Floyd-Fish/Lab-Precision-VoltageSource/README.md

# Lab-Precision-VoltageSource
A 18-bit Precision Bipolar DAC Module based on LTC2756&amp;LTC6655-2.5 with PMOD Interface

Article explaining the principle: https://www.emoe.xyz/precision-voltage-source-design/

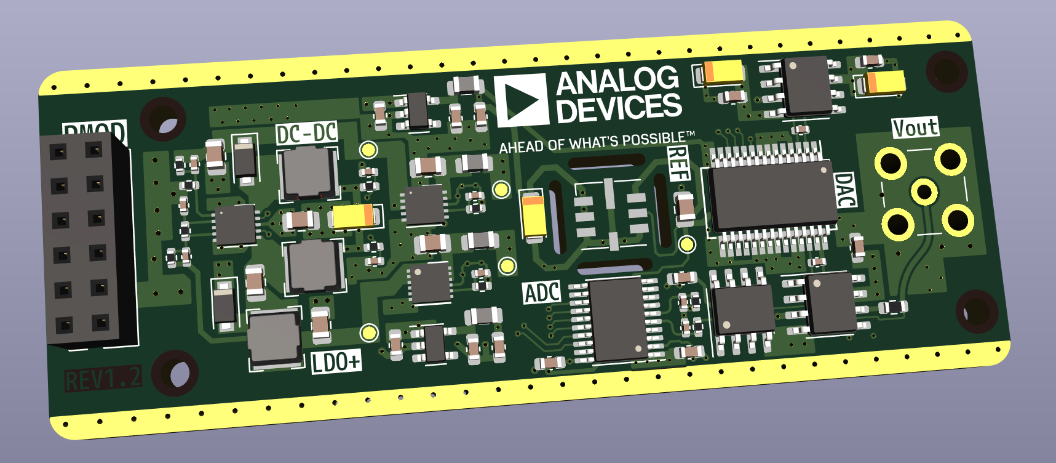
[picture p1: img/1.png]


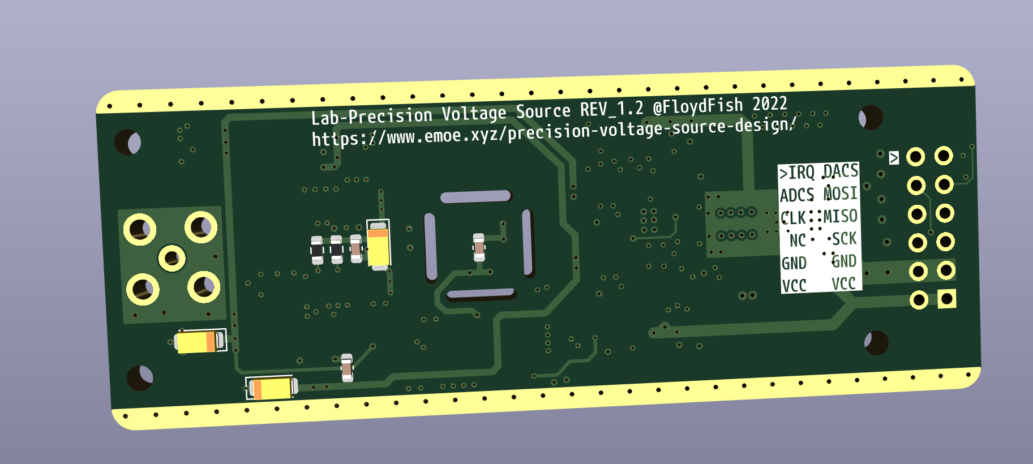
[picture p2: img/2.png]
