Floyd-Fish/Lab-Precision-VoltageSource/LabPrecisionVoltageSource_V1.2/LabPrecisionVoltageSource_V1.2.kicad_pcb

## KiCad design LabPrecisionVoltageSource_V1.2/LabPrecisionVoltageSource_V1.2.kicad_pcb (2023-03-18)

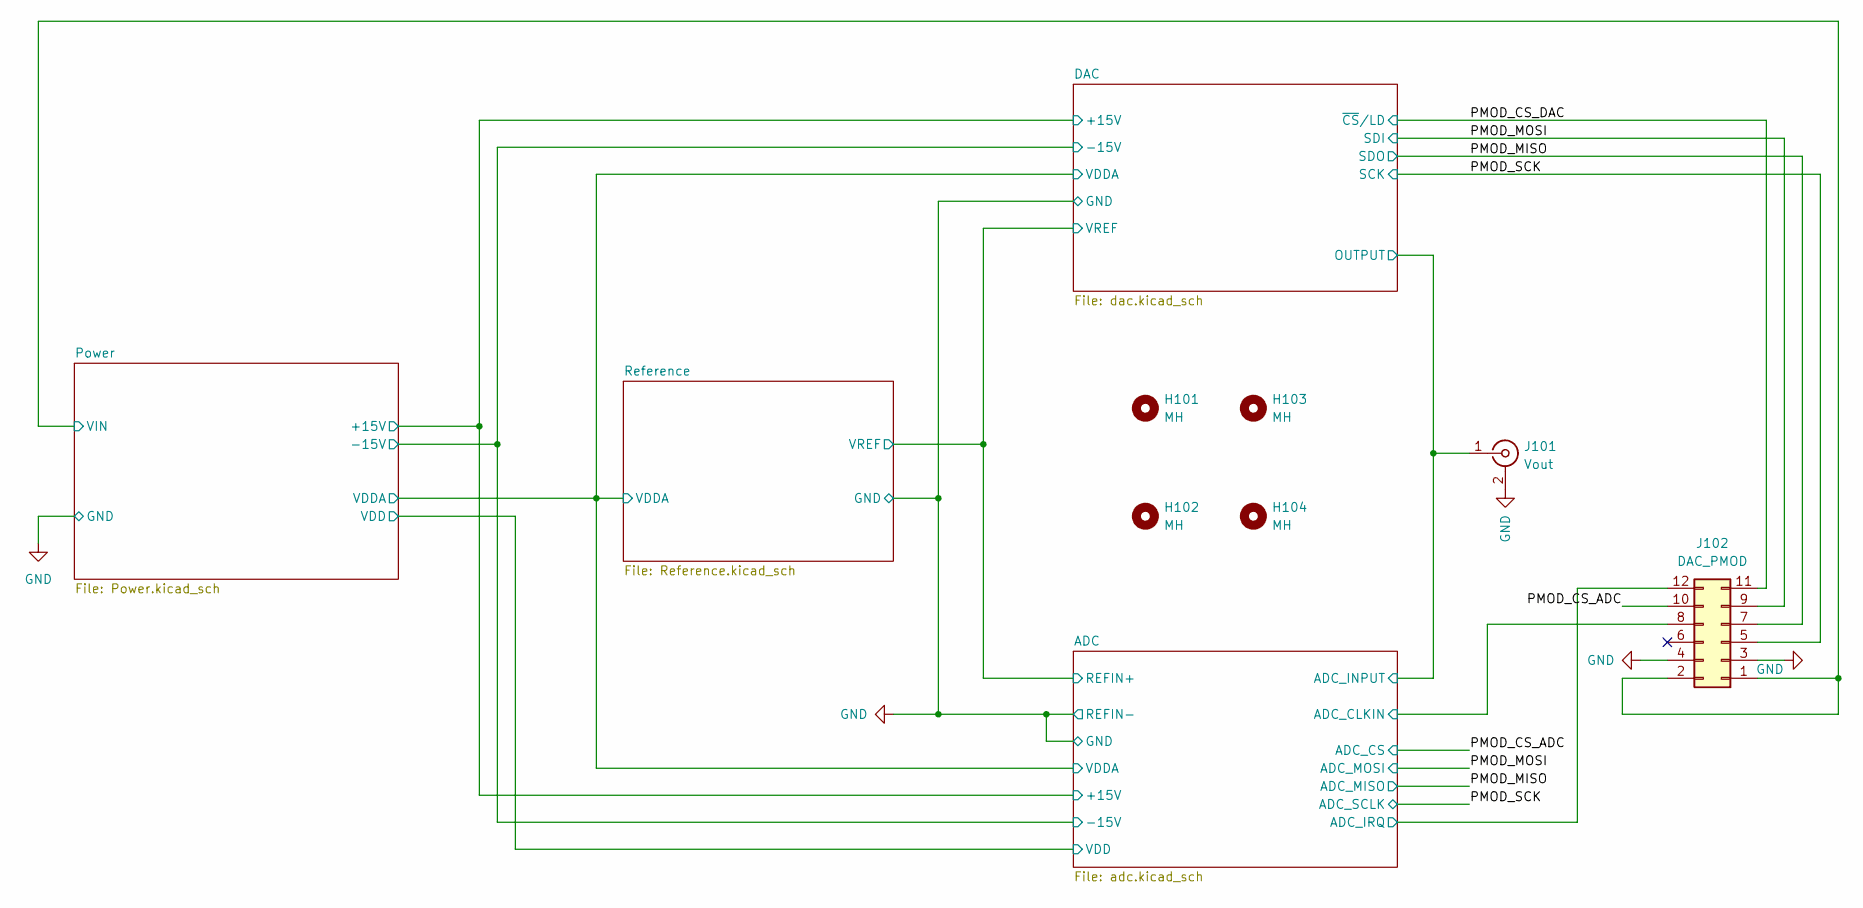
[picture p3: schematic LabPrecisionVoltageSource_V1.2.kicad_sch]

Parts:
H101, H102, H103, H104: MH; MountingHole_2.2mm_M2_ISO7380
J101: Vout; SMB_Jack_Vertical
J102: DAC_PMOD; PinSocket_2x06_P2.54mm_Vertical

Connections:
/ADC/ADC_CLKIN: J102.8; also elsewhere on the board
/ADC/ADC_INPUT: J101.1 (In); also elsewhere on the board
/ADC/ADC_IRQ: J102.12; also elsewhere on the board
/PMOD_CS_ADC: J102.10; also elsewhere on the board
/PMOD_CS_DAC: J102.11; also elsewhere on the board
/PMOD_MISO: J102.7; also elsewhere on the board
/PMOD_MOSI: J102.9; also elsewhere on the board
/PMOD_SCK: J102.5; also elsewhere on the board
GND: J101.2 (Ext), J102.3, J102.4; also elsewhere on the board
VIN: J102.1, J102.2; also elsewhere on the board

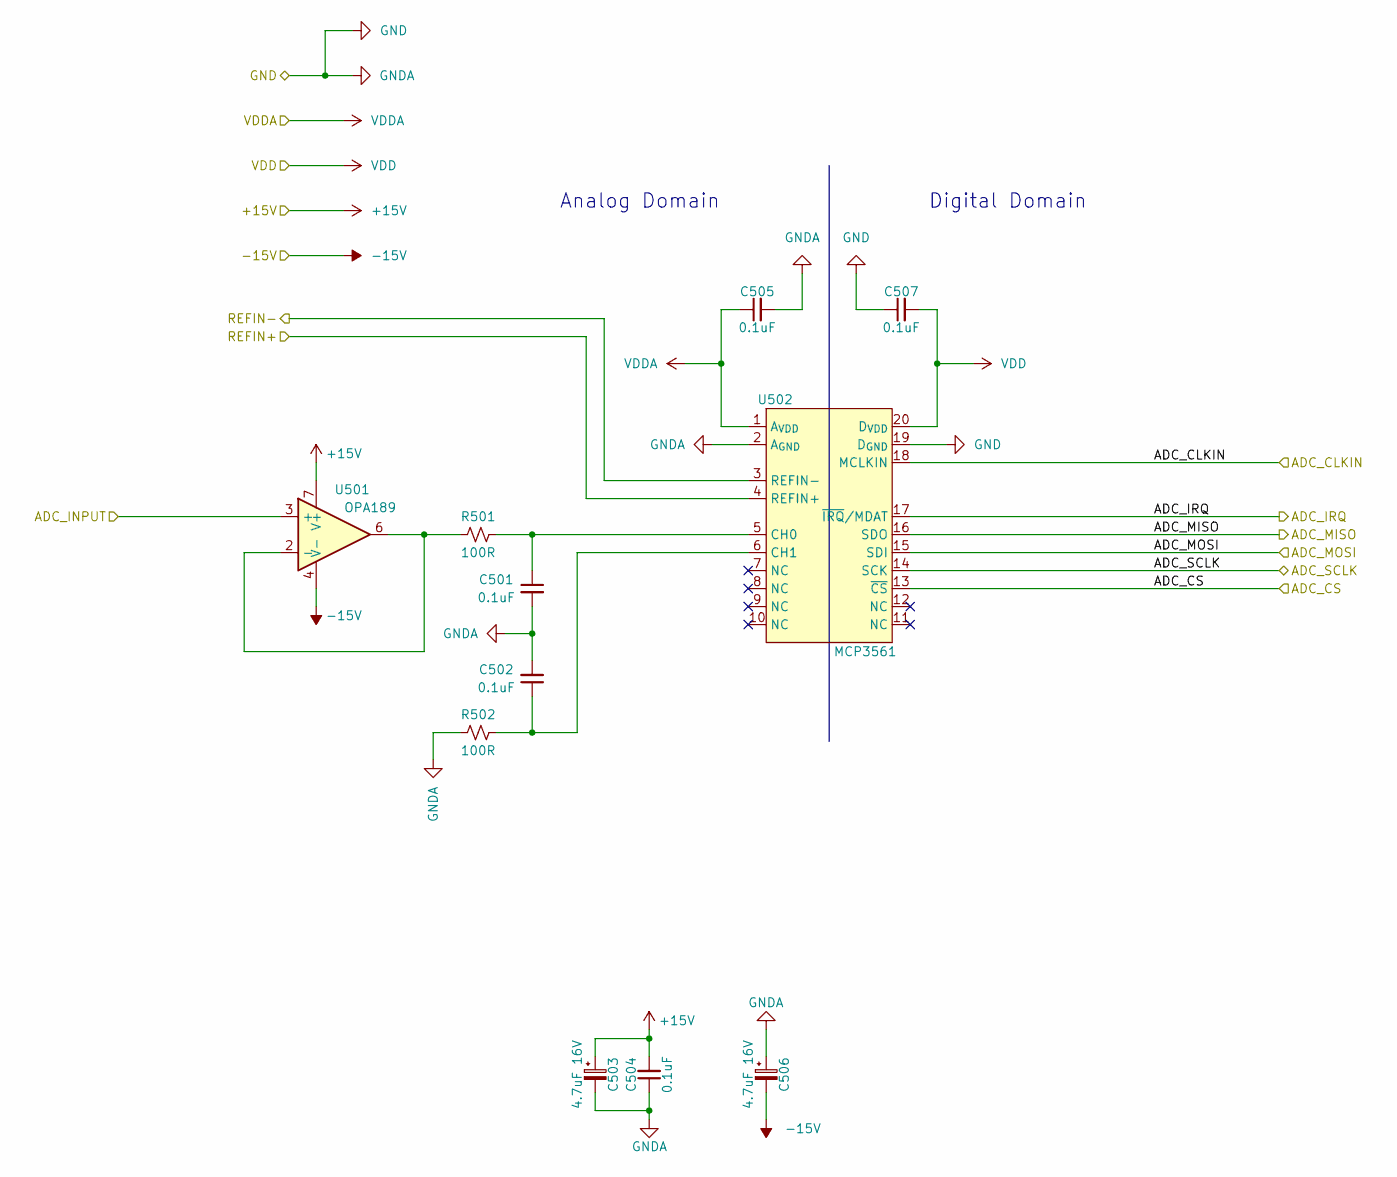
[picture p4: schematic adc.kicad_sch, Lab-Precision Voltage Source]

Parts:
C501, C502: 0.1uF; C_0402_1005Metric
C503, C506: 4.7uF 16V; CP_EIA-3216-10_Kemet-I
C504, C505, C507: 0.1uF; C_0603_1608Metric
R501, R502: 100R; R_0402_1005Metric
U501: OPA189; SOIC-8_3.9x4.9mm_P1.27mm
U502: MCP3561; TSSOP-20_4.4x6.5mm_P0.65mm

Connections:
+15V: C503.1, C504.2, U501.7 (V+); also elsewhere on the board
-15V: C506.2, U501.4 (V-); also elsewhere on the board
/ADC/ADC_CLKIN: U502.18 (MCLKIN); also elsewhere on the board
/ADC/ADC_INPUT: U501.3 (+); also elsewhere on the board
/ADC/ADC_IRQ: U502.17 (~IRQ/MDAT); also elsewhere on the board
/PMOD_CS_ADC: U502.13 (~CS); also elsewhere on the board
/PMOD_MISO: U502.16 (SDO); also elsewhere on the board
/PMOD_MOSI: U502.15 (SDI); also elsewhere on the board
/PMOD_SCK: U502.14 (SCK); also elsewhere on the board
/Reference/VREF: U502.4 (REFIN+); also elsewhere on the board
GND: C501.2, C502.2, C503.2, C504.1, C505.2, C506.1, C507.1, R502.2, U502.2 (A_{GND}), U502.3 (REFIN-), U502.19 (D_{GND}); also elsewhere on the board
unnamed: C501.1, R501.1, U502.5 (CH0)
unnamed: C502.1, R502.1, U502.6 (CH1)
unnamed: R501.2, U501.2 (-), U501.6
VDD: C507.2, U502.20 (D_{VDD}); also elsewhere on the board
VDDA: C505.1, U502.1 (A_{VDD}); also elsewhere on the board

Notes on the sheet:
Analog Domain
Digital Domain

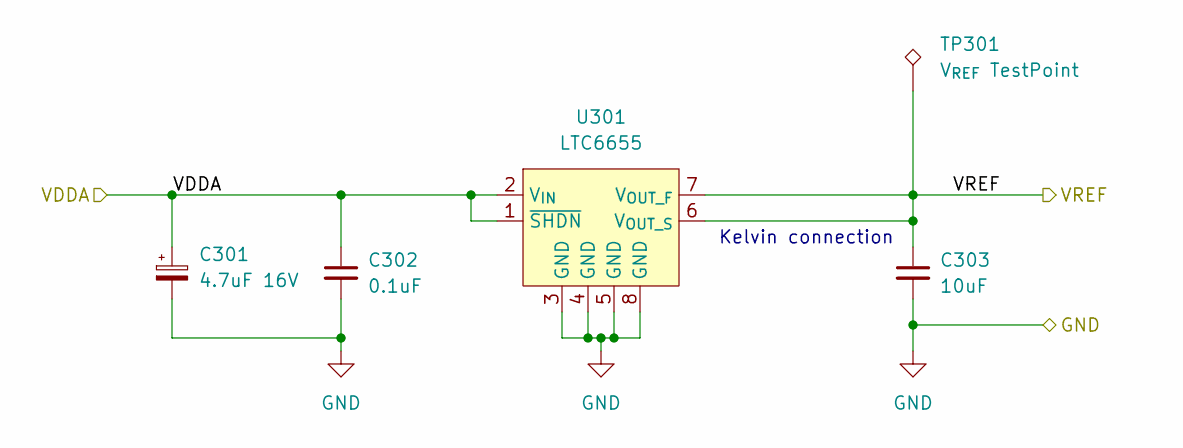
[picture p5: schematic Reference.kicad_sch, Lab-Precision Voltage Source]

Parts:
C301: 4.7uF 16V; CP_EIA-3216-10_Kemet-I
C302: 0.1uF; C_0603_1608Metric
C303: 10uF; C_0805_2012Metric
TP301: V_{REF} TestPoint; TestPoint_Pad_D1.0mm
U301: LTC6655; Linear_LS8

Connections:
/Reference/VREF: C303.1, TP301.1, U301.6 (V_{OUT_S}), U301.7 (V_{OUT_F}); also elsewhere on the board
GND: C301.2, C302.2, C303.2, U301.3 (GND), U301.4 (GND), U301.5 (GND), U301.8 (GND); also elsewhere on the board
VDDA: C301.1, C302.1, U301.1 (~SHDN), U301.2 (V_{IN}); also elsewhere on the board

Notes on the sheet:
Kelvin connection

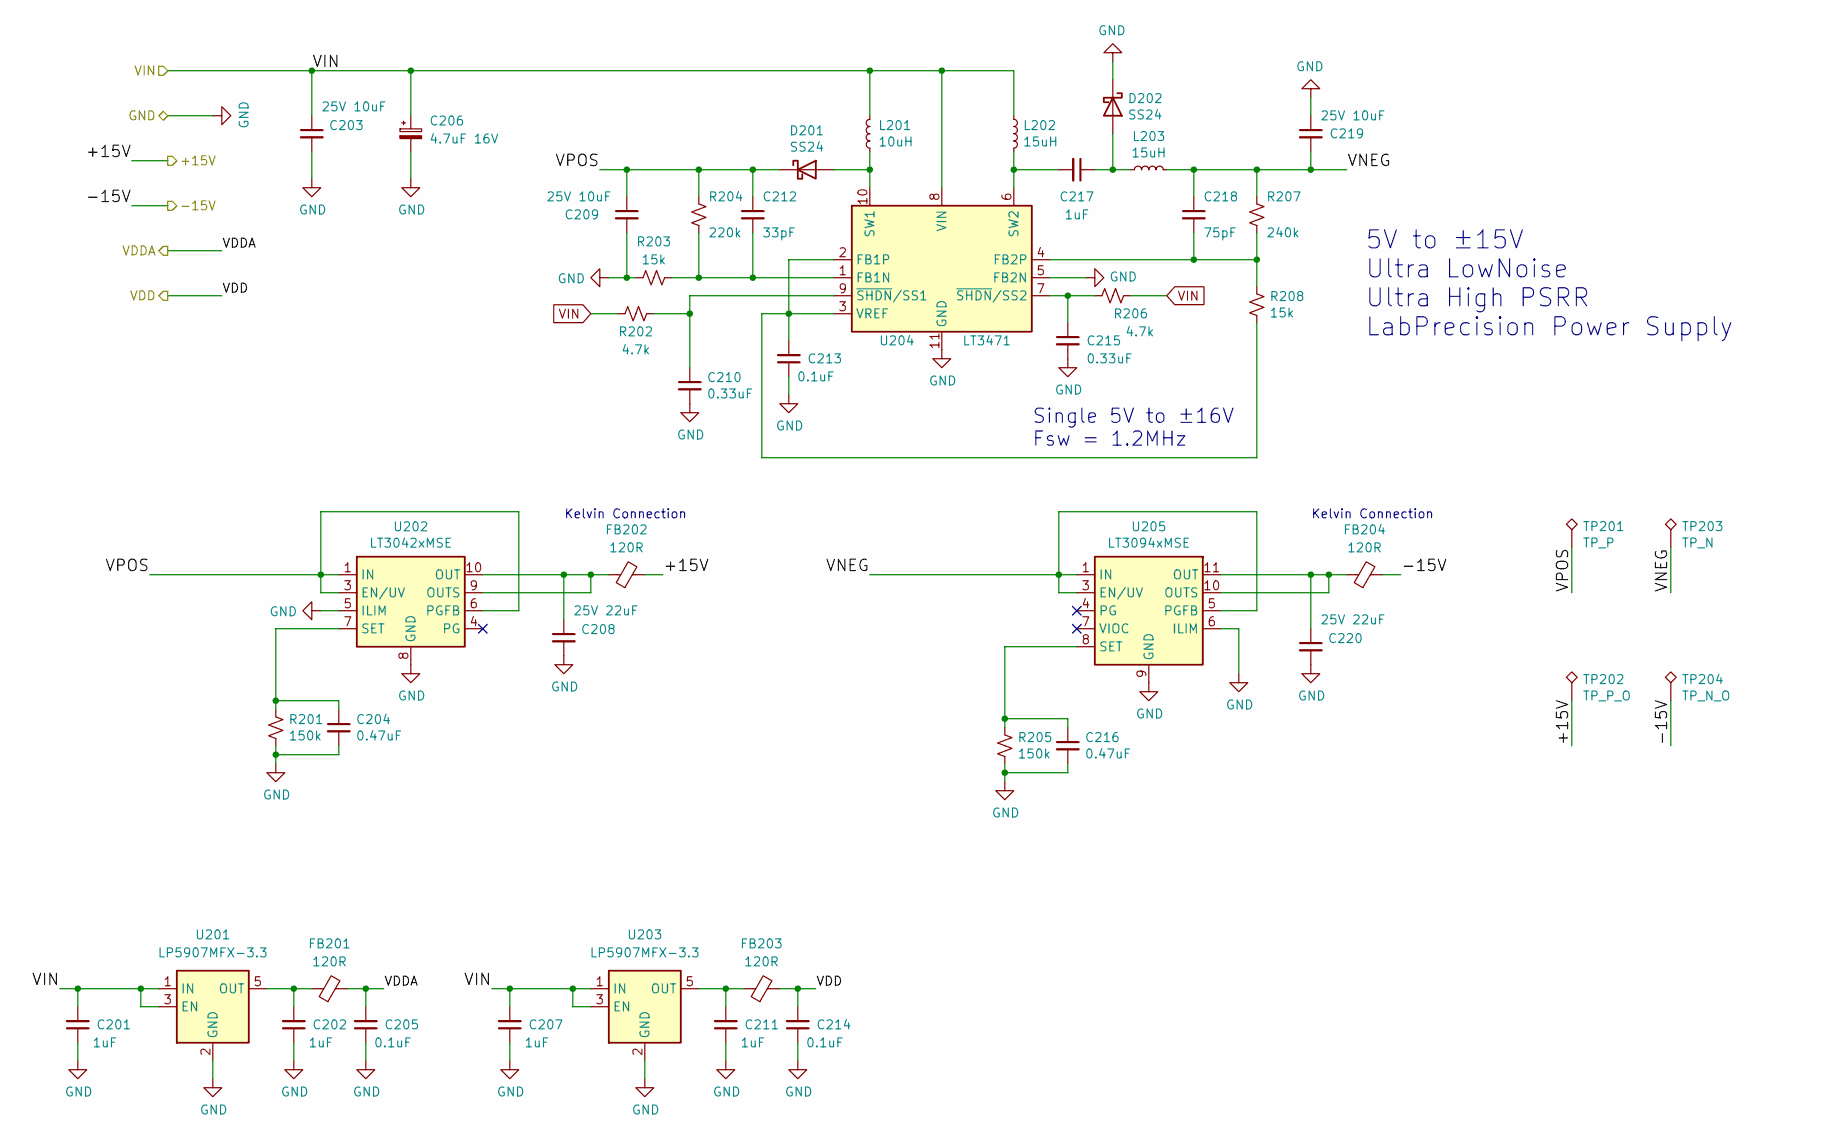
[picture p6: schematic Power.kicad_sch, Lab-Precision Voltage Source]

Parts:
C201, C202, C207, C211: 1uF; C_0603_1608Metric
C203, C209, C219: 25V 10uF; C_0805_2012Metric
C204, C216: 0.47uF; C_0402_1005Metric
C205, C214: 0.1uF; C_0603_1608Metric
C206: 4.7uF 16V; CP_EIA-3216-10_Kemet-I
C208, C220: 25V 22uF; C_0805_2012Metric
C210, C215: 0.33uF; C_0402_1005Metric
C212: 33pF; C_0402_1005Metric
C213: 0.1uF; C_0402_1005Metric
C217: 1uF; C_0805_2012Metric
C218: 75pF; C_0402_1005Metric
D201, D202: SS24; D_SOD-123F
FB201, FB202, FB203, FB204: 120R; L_0805_2012Metric
L201: 10uH; L_Bourns-SRN4018
L202, L203: 15uH; L_Bourns-SRN4018
R201, R205: 150k; R_0402_1005Metric
R202, R206: 4.7k; R_0402_1005Metric
R203, R208: 15k; R_0402_1005Metric
R204: 220k; R_0402_1005Metric
R207: 240k; R_0402_1005Metric
TP201: TP_P; TestPoint_Pad_D1.0mm
TP202: TP_P_O; TestPoint_Pad_D1.0mm
TP203: TP_N; TestPoint_Pad_D1.0mm
TP204: TP_N_O; TestPoint_Pad_D1.0mm
U201, U203: LP5907MFX-3.3; SOT-23-5
U202: LT3042xMSE; DFN-10-1EP_3x3mm_P0.5mm_EP1.65x2.38mm
U204: LT3471; DFN-10-1EP_3x3mm_P0.5mm_EP1.65x2.38mm
U205: LT3094xMSE; DFN-12-1EP_3x3mm_P0.45mm_EP1.66x2.38mm

Connections:
+15V: FB202.2, TP202.1; also elsewhere on the board
-15V: FB204.2, TP204.1; also elsewhere on the board
/Power/VNEG: C218.1, C219.2, L203.2, R207.2, TP203.1, U205.1 (IN), U205.2 (IN), U205.3 (EN/UV), U205.5 (PGFB), U205.13 (IN)
/Power/VPOS: C209.1, C212.1, D201.1 (K), R204.2, TP201.1, U202.1 (IN), U202.2 (IN), U202.3 (EN/UV), U202.6 (PGFB)
GND: C201.1, C202.1, C203.2, C204.2, C205.1, C206.2, C207.1, C208.2, C209.2, C210.2, C211.1, C213.1, C214.1, C215.2, C216.2, C219.1, C220.2, D202.1 (K), R201.1, R203.1, R205.1, U201.2 (GND), U202.5 (ILIM), U202.8 (GND), U202.11 (GND), U203.2 (GND), U204.5 (FB2N), U204.11 (GND), U205.6 (ILIM), U205.9 (GND); also elsewhere on the board
unnamed: C202.2, FB201.1, U201.5 (OUT)
unnamed: C204.1, R201.2, U202.7 (SET)
unnamed: C208.1, FB202.1, U202.9 (OUTS), U202.10 (OUT)
unnamed: C210.1, R202.2, U204.9 (~SHDN/SS1)
unnamed: C211.2, FB203.1, U203.5 (OUT)
unnamed: C212.2, R203.2, R204.1, U204.1 (FB1N)
unnamed: C213.2, R208.1, U204.2 (FB1P), U204.3 (VREF)
unnamed: C215.1, R206.1, U204.7 (~SHDN/SS2)
unnamed: C216.1, R205.2, U205.8 (SET)
unnamed: C217.1, D202.2 (A), L203.1
unnamed: C217.2, L202.2, U204.6 (SW2)
unnamed: C218.2, R207.1, R208.2, U204.4 (FB2P)
unnamed: C220.1, FB204.1, U205.10 (OUTS), U205.11 (OUT), U205.12 (OUT)
unnamed: D201.2 (A), L201.1, U204.10 (SW1)
VDD: C214.2, FB203.2; also elsewhere on the board
VDDA: C205.2, FB201.2; also elsewhere on the board
VIN: C201.2, C203.1, C206.1, C207.2, L201.2, L202.1, R202.1, R206.2, U201.1 (IN), U201.3 (EN), U203.1 (IN), U203.3 (EN), U204.8 (VIN); also elsewhere on the board

Notes on the sheet:
Kelvin Connection
Single 5V to ±16V Fsw = 1.2MHz
5V to ±15V Ultra LowNoise Ultra High PSRR LabPrecision Power Supply

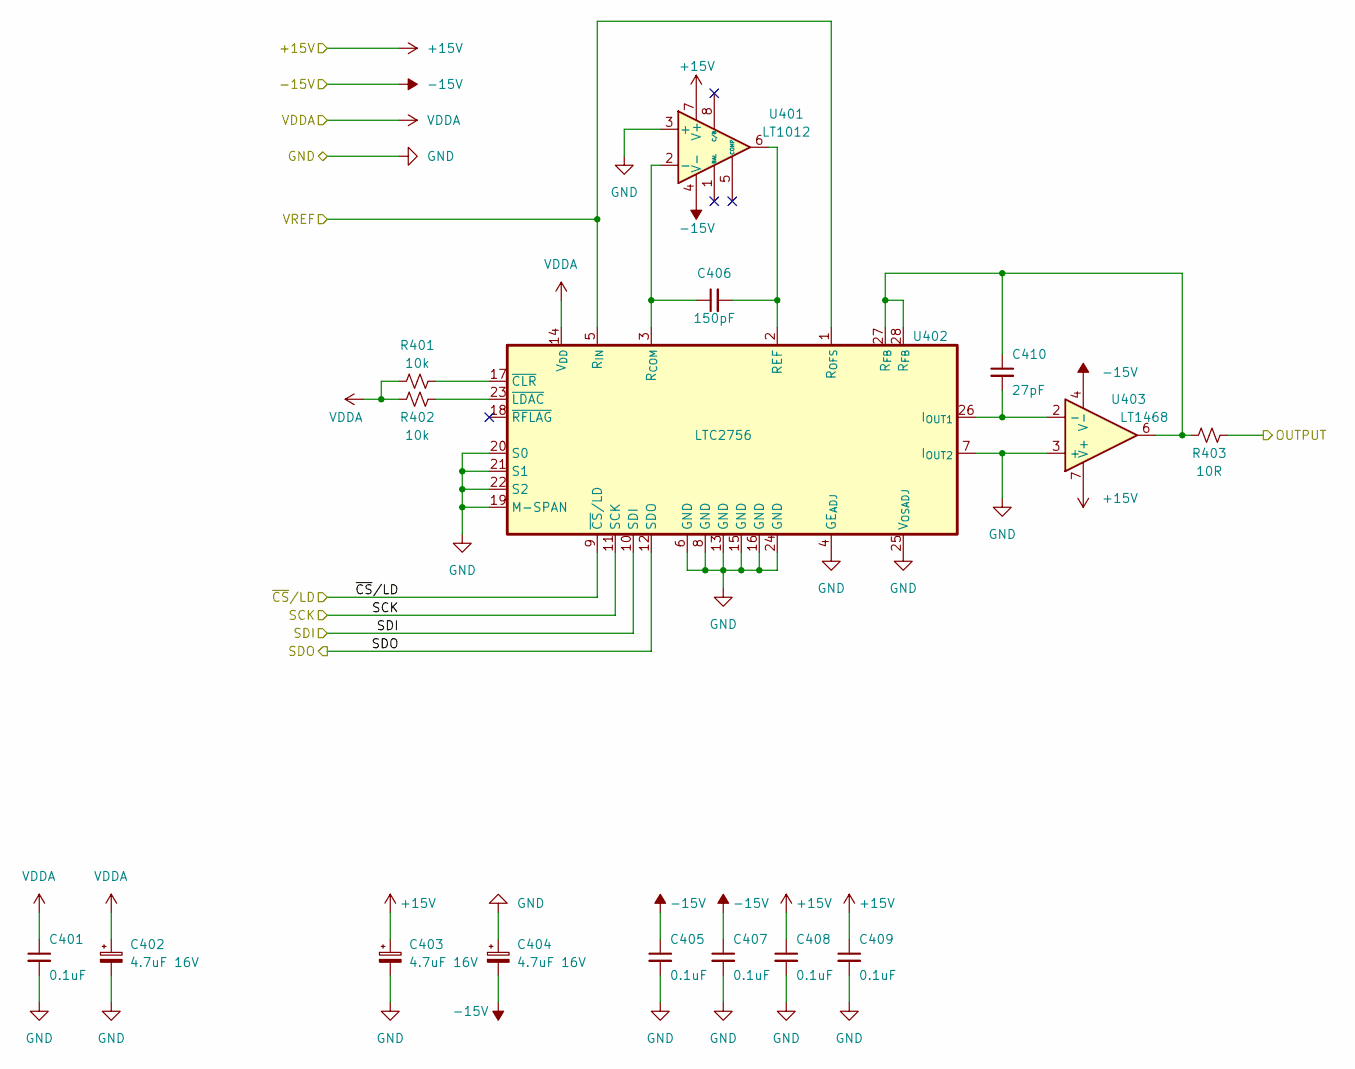
[picture p7: schematic dac.kicad_sch, Lab-Precision Voltage Source]

Parts:
C401, C405, C407, C408, C409: 0.1uF; C_0603_1608Metric
C402, C403, C404: 4.7uF 16V; CP_EIA-3216-10_Kemet-I
C406: 150pF; C_0402_1005Metric
C410: 27pF; C_0402_1005Metric
R401, R402: 10k; R_0603_1608Metric
R403: 10R; R_0603_1608Metric
U401: LT1012; SOIC-8_3.9x4.9mm_P1.27mm
U402: LTC2756; SSOP-28_5.3x10.2mm_P0.65mm
U403: LT1468; SOIC-8_3.9x4.9mm_P1.27mm

Connections:
+15V: C403.1, C408.1, C409.1, U401.7 (V+), U403.7 (V+); also elsewhere on the board
-15V: C404.2, C405.1, C407.1, U401.4 (V-), U403.4 (V-); also elsewhere on the board
/ADC/ADC_INPUT: R403.1; also elsewhere on the board
/PMOD_CS_DAC: U402.9 (~CS/LD); also elsewhere on the board
/PMOD_MISO: U402.12 (SDO); also elsewhere on the board
/PMOD_MOSI: U402.10 (SDI); also elsewhere on the board
/PMOD_SCK: U402.11 (SCK); also elsewhere on the board
/Reference/VREF: U402.1 (R_{OFS}), U402.5 (R_{IN}); also elsewhere on the board
GND: C401.2, C402.2, C403.2, C404.1, C405.2, C407.2, C408.2, C409.2, U401.3 (+), U402.4 (GE_{ADJ}), U402.6 (GND), U402.7 (I_{OUT2}), U402.8 (GND), U402.13 (GND), U402.15 (GND), U402.16 (GND), U402.19 (M-SPAN), U402.20 (S0), U402.21 (S1), U402.22 (S2), U402.24 (GND), U402.25 (V_{OSADJ}), U403.3 (+); also elsewhere on the board
unnamed: C406.1, U401.2 (-), U402.3 (R_{COM})
unnamed: C406.2, U401.6, U402.2 (REF)
unnamed: C410.1, R403.2, U402.27 (R_{FB}), U402.28 (R_{FB}), U403.6
unnamed: C410.2, U402.26 (I_{OUT1}), U403.2 (-)
unnamed: R401.1, U402.17 (~CLR)
unnamed: R402.1, U402.23 (~LDAC)
VDDA: C401.1, C402.1, R401.2, R402.2, U402.14 (V_{DD}); also elsewhere on the board

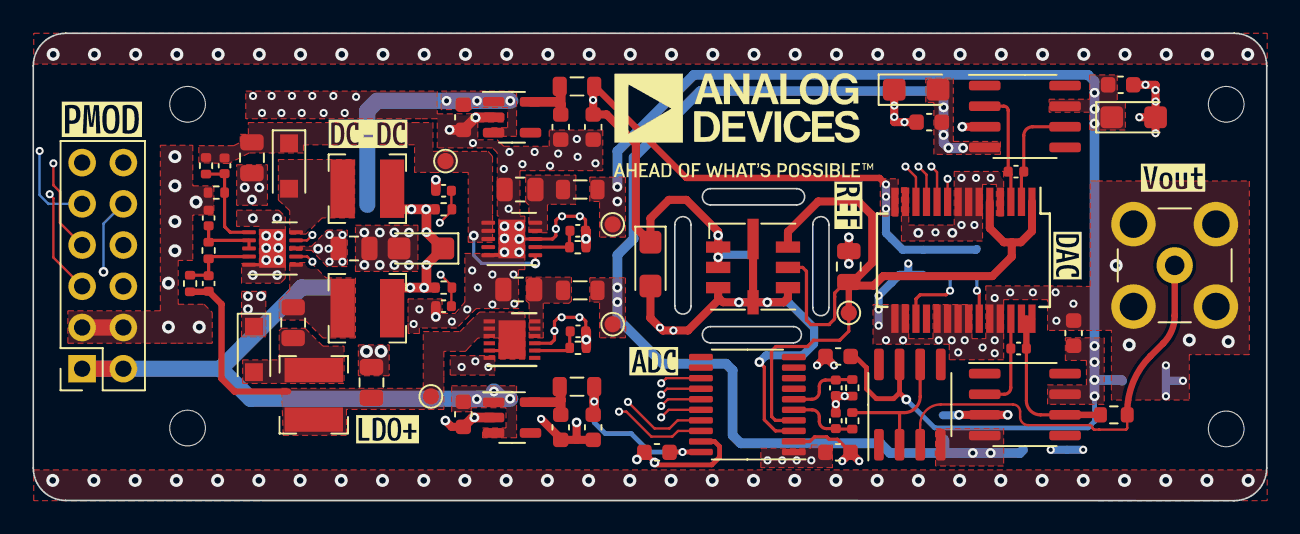
[picture p8: board LabPrecisionVoltageSource_V1.2.kicad_pcb from above]

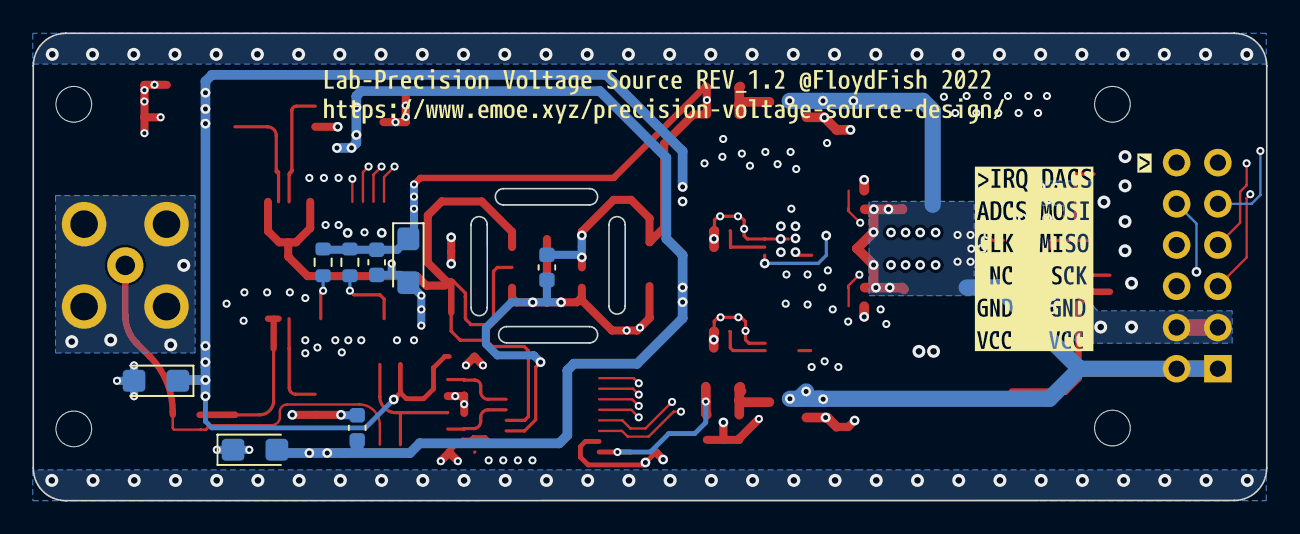
[picture p9: board LabPrecisionVoltageSource_V1.2.kicad_pcb from below]

Board: 4 copper layers, 76.0 x 28.8 mm, 96 parts (12 on the bottom side), 40 nets.

Other parts of the board:
kibuzzard-63418A0A: G***; kibuzzard-63418A0A
kibuzzard-63418A1A: G***; kibuzzard-63418A1A
kibuzzard-63418A4B: G***; kibuzzard-63418A4B
kibuzzard-63418A24: G***; kibuzzard-63418A24
kibuzzard-634188FD: G***; kibuzzard-634188FD
kibuzzard-634189C4: G***; kibuzzard-634189C4
kibuzzard-634189ED: G***; kibuzzard-634189ED
kibuzzard-634189F6: G***; kibuzzard-634189F6
kibuzzard-634189FF: G***; kibuzzard-634189FF
kibuzzard-6341896C: G***; kibuzzard-6341896C
kibuzzard-63418870: G***; kibuzzard-63418870
kibuzzard-63418876: G***; kibuzzard-63418876
