Floyd-Fish/Lab-Precision-VoltageSource/(notices)

Notices in the files:
LabPrecisionVoltageSource_V1.2/adc.kicad_sch:
©Floydfish 2022
